bullestock/chairbot/arm/grblHAL/settings.txt

GrblHAL 1.1f ['$' or '$HELP' for help]
$0=10.0
$1=25
$2=0
$3=0
$4=7
$5=7
$6=1
$9=1
$10=511
$11=0.010
$12=0.002
$13=0
$14=7
$15=0
$16=0
$17=0
$18=1
$19=0
$20=1
$21=0
$22=11
$23=1
$24=250.0
$25=1000.0
$26=250
$27=5.000
$28=0.100
$29=0.0
$30=1000.000
$31=0.000
$32=0
$33=5000.0
$34=0.0
$35=0.0
$36=100.0
$37=0
$39=1
$40=0
$43=1
$44=4
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
ok
