bullestock/chairbot/base.dxf

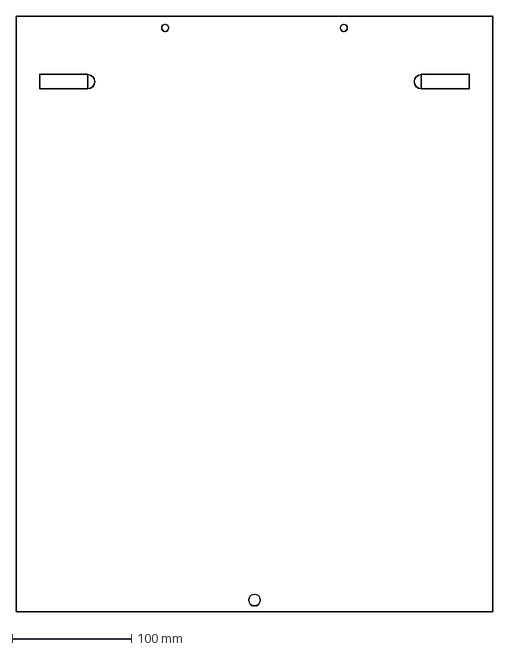
[picture p1: CAD file, 2016-07-29]
base.dxf
400.0 x 500.0 mm
