bullestock/chairbot/spacer.dxf

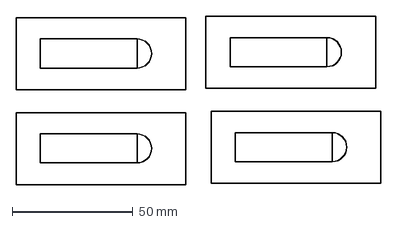
[picture p2: CAD file, 2016-07-29]
spacer.dxf
150.8 x 69.6 mm
