bullestock/chairbot/pcb/peripherals/peripherals.kicad_pcb

## KiCad design pcb/peripherals/peripherals.kicad_pcb (2026-04-26)

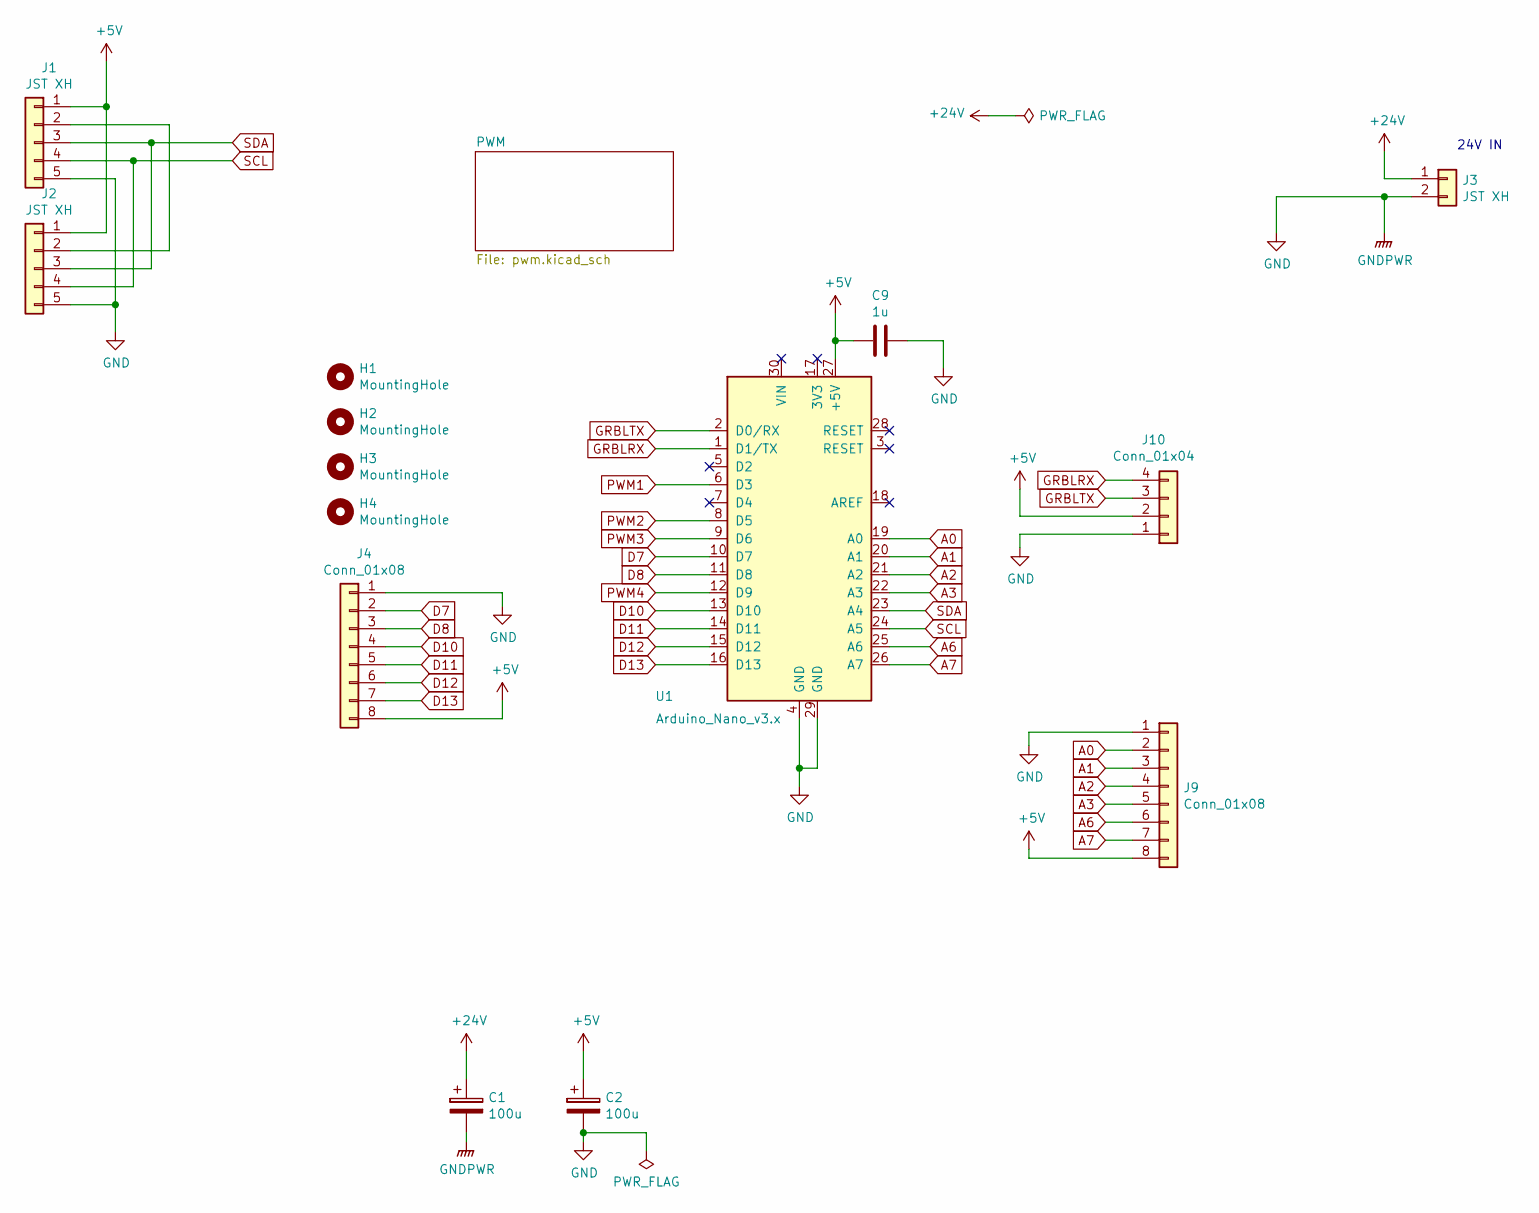
[picture p3: schematic peripherals.kicad_sch]

Parts:
C1, C2: 100u; CP_Elec_10x10
C9: 1u; C_0805_2012Metric
H1, H2, H3, H4: MountingHole; MountingHole_3.2mm_M3
J1, J2: JST XH; JST_XH_B05B-XH-A_1x05_P2.50mm_Vertical
J3: JST XH; JST_XH_B02B-XH-A_1x02_P2.50mm_Vertical
J4, J9: Conn_01x08; JST_XH_B08B-XH-A_1x08_P2.50mm_Vertical
J10: Conn_01x04; JST_XH_B04B-XH-A_1x04_P2.50mm_Vertical
U1: Arduino_Nano_v3.x; Arduino_Nano

Connections:
+5V: C2.1, C9.2, J1.1, J2.1, J4.8, J9.8, J10.2, U1.27 (+5V)
+24V: C1.1, J3.1; also elsewhere on the board
A0: J9.2, U1.19 (A0)
A1: J9.3, U1.20 (A1)
A2: J9.4, U1.21 (A2)
A3: J9.5, U1.22 (A3)
A6: J9.6, U1.25 (A6)
A7: J9.7, U1.26 (A7)
D7: J4.2, U1.10 (D7)
D8: J4.3, U1.11 (D8)
D10: J4.4, U1.13 (D10)
D11: J4.5, U1.14 (D11)
D12: J4.6, U1.15 (D12)
D13: J4.7, U1.16 (D13)
GND: C1.2, C2.2, C9.1, J1.5, J2.5, J3.2, J4.1, J9.1, J10.1, U1.4 (GND), U1.29 (GND); also elsewhere on the board
GRBLRX: J10.4, U1.1 (D1/TX)
GRBLTX: J10.3, U1.2 (D0/RX)
unnamed: J1.2, J2.2
PWM1: U1.6 (D3); also elsewhere on the board
PWM2: U1.8 (D5); also elsewhere on the board
PWM3: U1.9 (D6); also elsewhere on the board
PWM4: U1.12 (D9); also elsewhere on the board
SCL: J1.4, J2.4, U1.24 (A5)
SDA: J1.3, J2.3, U1.23 (A4)

Notes on the sheet:
24V IN

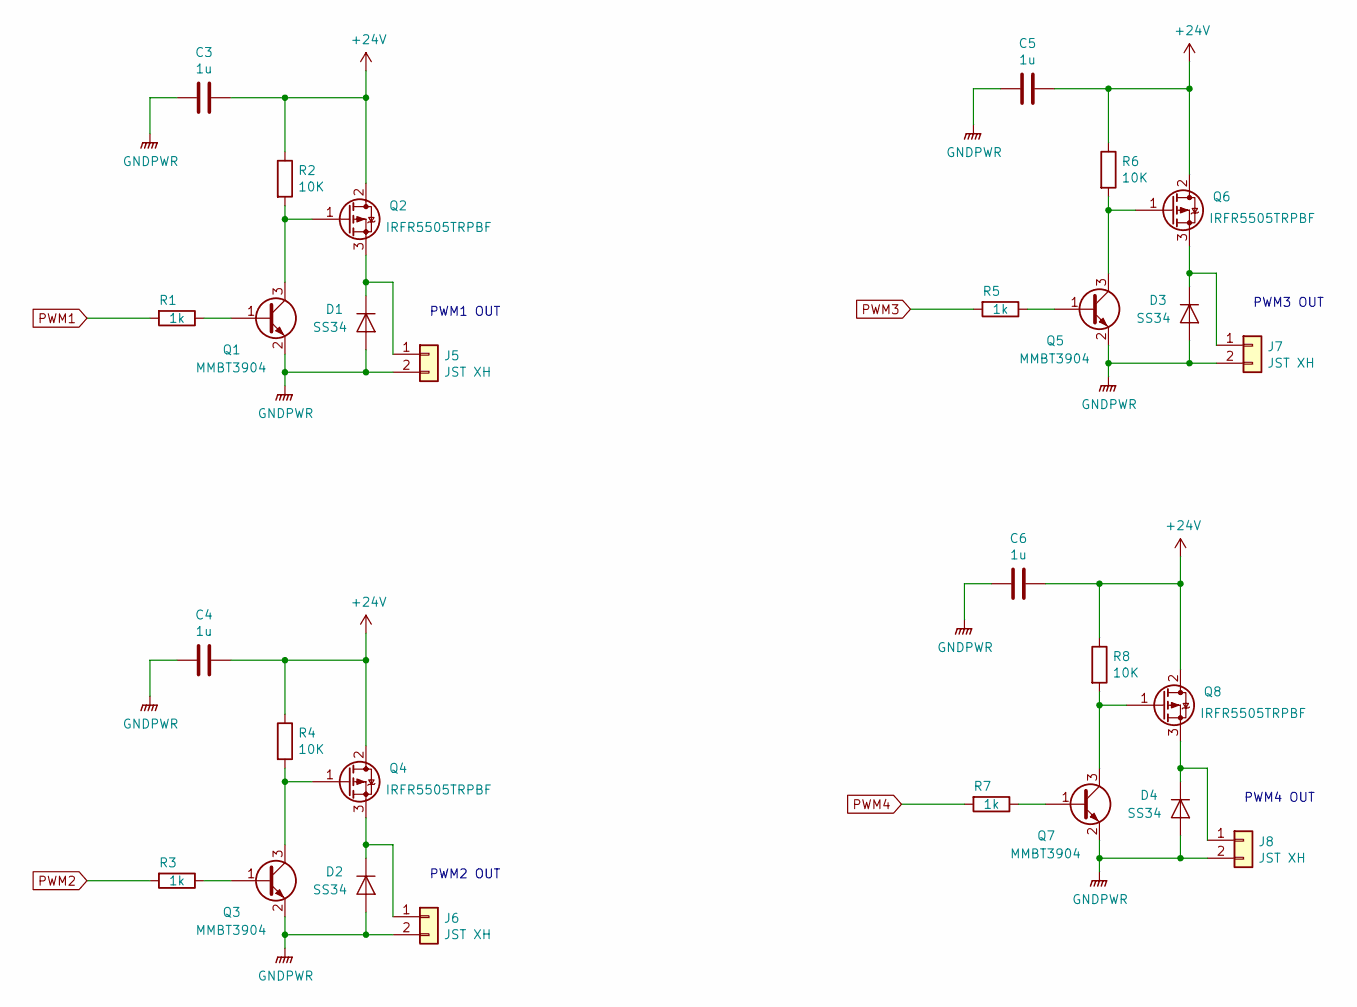
[picture p4: schematic pwm.kicad_sch]

Parts:
C3, C4, C5, C6: 1u; C_0805_2012Metric
D1, D2, D3, D4: SS34; D_SMB
J5, J6, J7, J8: JST XH; JST_XH_B02B-XH-A_1x02_P2.50mm_Vertical
Q1, Q3, Q5, Q7: MMBT3904; SOT-23
Q2, Q4, Q6, Q8: IRFR5505TRPBF; TO-252-3_TabPin2
R1, R3, R5, R7: 1k; R_0603_1608Metric
R2, R4, R6, R8: 10K; R_0603_1608Metric

Connections:
+24V: C3.1, C4.1, C5.1, C6.1, Q2.2 (D), Q4.2 (D), Q6.2 (D), Q8.2 (D), R2.1, R4.1, R6.1, R8.1; also elsewhere on the board
GND: C3.2, C4.2, C5.2, C6.2, D1.2 (A), D2.2 (A), D3.2 (A), D4.2 (A), J5.2, J6.2, J7.2, J8.2, Q1.2 (E), Q3.2 (E), Q5.2 (E), Q7.2 (E); also elsewhere on the board
unnamed: D1.1 (K), J5.1, Q2.3 (S)
unnamed: D2.1 (K), J6.1, Q4.3 (S)
unnamed: D3.1 (K), J7.1, Q6.3 (S)
unnamed: D4.1 (K), J8.1, Q8.3 (S)
unnamed: Q1.1 (B), R1.1
unnamed: Q1.3 (C), Q2.1 (G), R2.2
unnamed: Q3.1 (B), R3.1
unnamed: Q3.3 (C), Q4.1 (G), R4.2
unnamed: Q5.1 (B), R5.1
unnamed: Q5.3 (C), Q6.1 (G), R6.2
unnamed: Q7.1 (B), R7.1
unnamed: Q7.3 (C), Q8.1 (G), R8.2
PWM1: R1.2; also elsewhere on the board
PWM2: R3.2; also elsewhere on the board
PWM3: R5.2; also elsewhere on the board
PWM4: R7.2; also elsewhere on the board

Notes on the sheet:
PWM3 OUT
PWM1 OUT
PWM4 OUT
PWM2 OUT

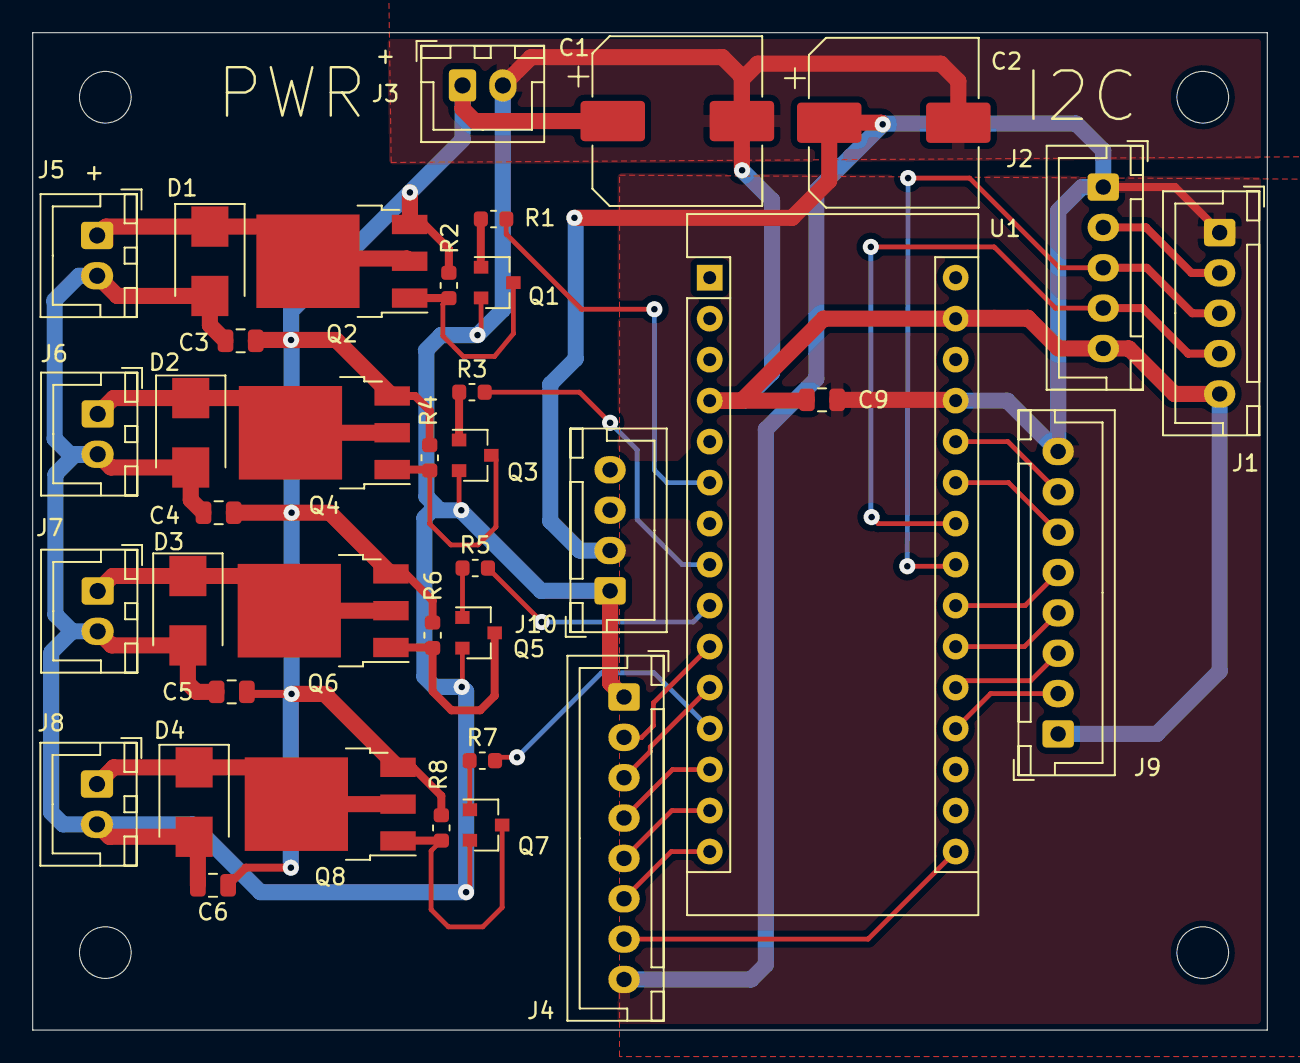
[picture p5: board peripherals.kicad_pcb from above]

Board: 2 copper layers, 76.5 x 61.8 mm, 42 parts (0 on the bottom side), 36 nets.
