bullestock/chairbot/pcb/chairbot/chairbot.kicad_pcb

## KiCad design pcb/chairbot/chairbot.kicad_pcb (2026-04-03)

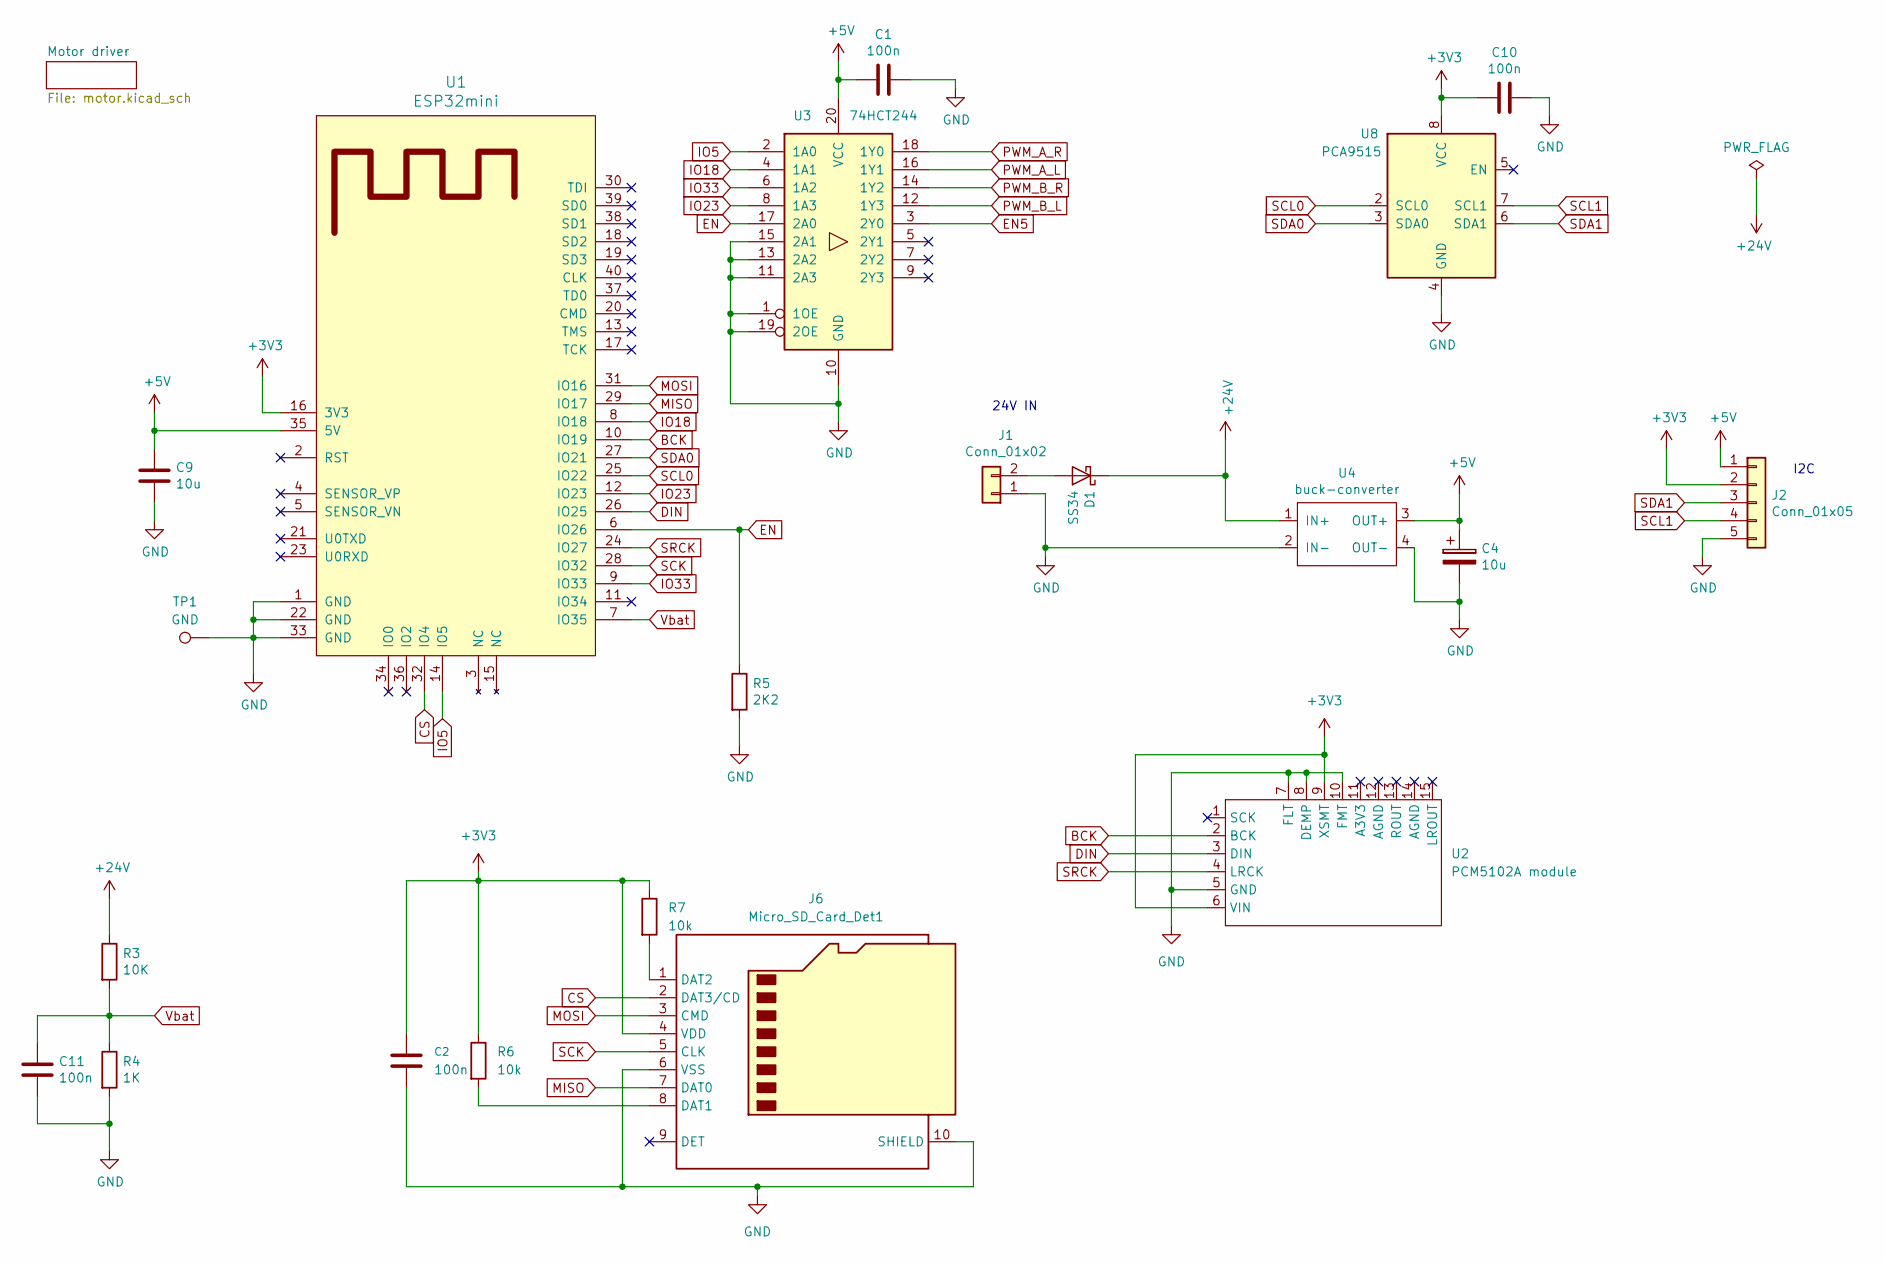
[picture p6: schematic chairbot.kicad_sch]

Parts:
C1, C2, C10, C11: 100n; C_0603_1608Metric
C4, C9: 10u; C_0805_2012Metric
D1: SS34; D_SMB
J1: Conn_01x02; JST_XH_B02B-XH-A_1x02_P2.50mm_Vertical
J2: Conn_01x05; JST_XH_B05B-XH-A_1x05_P2.50mm_Vertical
J6: Micro_SD_Card_Det1; J_SD_Card-micro_dual
R3: 10K; R_0603_1608Metric
R4: 1K; R_0603_1608Metric
R5: 2K2; R_0603_1608Metric
R6, R7: 10k; R_0603_1608Metric
TP1: GND; TestPoint_Loop_D1.80mm_Drill1.0mm_Beaded
U1: ESP32mini
U2: PCM5102A module
U3: 74HCT244; TSSOP-20_4.4x6.5mm_P0.65mm
U4: buck-converter
U8: PCA9515; TSSOP-8_3x3mm_P0.65mm

Connections:
+3V3: C2.1, C10.2, J2.2, J6.4 (VDD), R6.1, R7.1, U1.16 (3V3), U2.6 (VIN), U2.9 (XSMT), U8.8 (VCC)
+5V: C1.2, C4.1, C9.1, J2.1, U1.35 (5V), U3.20 (VCC), U4.3 (OUT+); also elsewhere on the board
+24V: D1.1 (K), R3.1, U4.1 (IN+); also elsewhere on the board
BCK: U1.10 (IO19), U2.2 (BCK)
CS: J6.2 (DAT3/CD), U1.32 (IO4)
DIN: U1.26 (IO25), U2.3 (DIN)
EN: R5.1, U1.6 (IO26), U3.17 (2A0)
EN5: U3.3 (2Y0); also elsewhere on the board
GND: C1.1, C2.2, C4.2, C9.2, C10.1, C11.2, J1.1, J2.5, J6.6 (VSS), J6.10 (SHIELD), R4.2, R5.2, TP1.1 (1_1), U1.1 (GND), U1.22 (GND), U1.33 (GND), U2.5 (GND), U2.7 (FLT), U2.8 (DEMP), U2.10 (FMT), U3.1 (1OE), U3.10 (GND), U3.11 (2A3), U3.13 (2A2), U3.15 (2A1), U3.19 (2OE), U4.2 (IN-), U4.4 (OUT-), U8.4 (GND); also elsewhere on the board
IO5: U1.14 (IO5), U3.2 (1A0)
IO18: U1.8 (IO18), U3.4 (1A1)
IO23: U1.12 (IO23), U3.8 (1A3)
IO33: U1.9 (IO33), U3.6 (1A2)
MISO: J6.7 (DAT0), U1.29 (IO17)
MOSI: J6.3 (CMD), U1.31 (IO16)
unnamed: D1.2 (A), J1.2
unnamed: J6.8 (DAT1), R6.2
unnamed: J6.1 (DAT2), R7.2
PWM_A_L: U3.16 (1Y1); also elsewhere on the board
PWM_A_R: U3.18 (1Y0); also elsewhere on the board
PWM_B_L: U3.12 (1Y3); also elsewhere on the board
PWM_B_R: U3.14 (1Y2); also elsewhere on the board
SCK: J6.5 (CLK), U1.28 (IO32)
SCL0: U1.25 (IO22), U8.2 (SCL0)
SCL1: J2.4, U8.7 (SCL1)
SDA0: U1.27 (IO21), U8.3 (SDA0)
SDA1: J2.3, U8.6 (SDA1)
SRCK: U1.24 (IO27), U2.4 (LRCK)
Vbat: C11.1, R3.2, R4.1, U1.7 (IO35)

Notes on the sheet:
I2C
24V IN

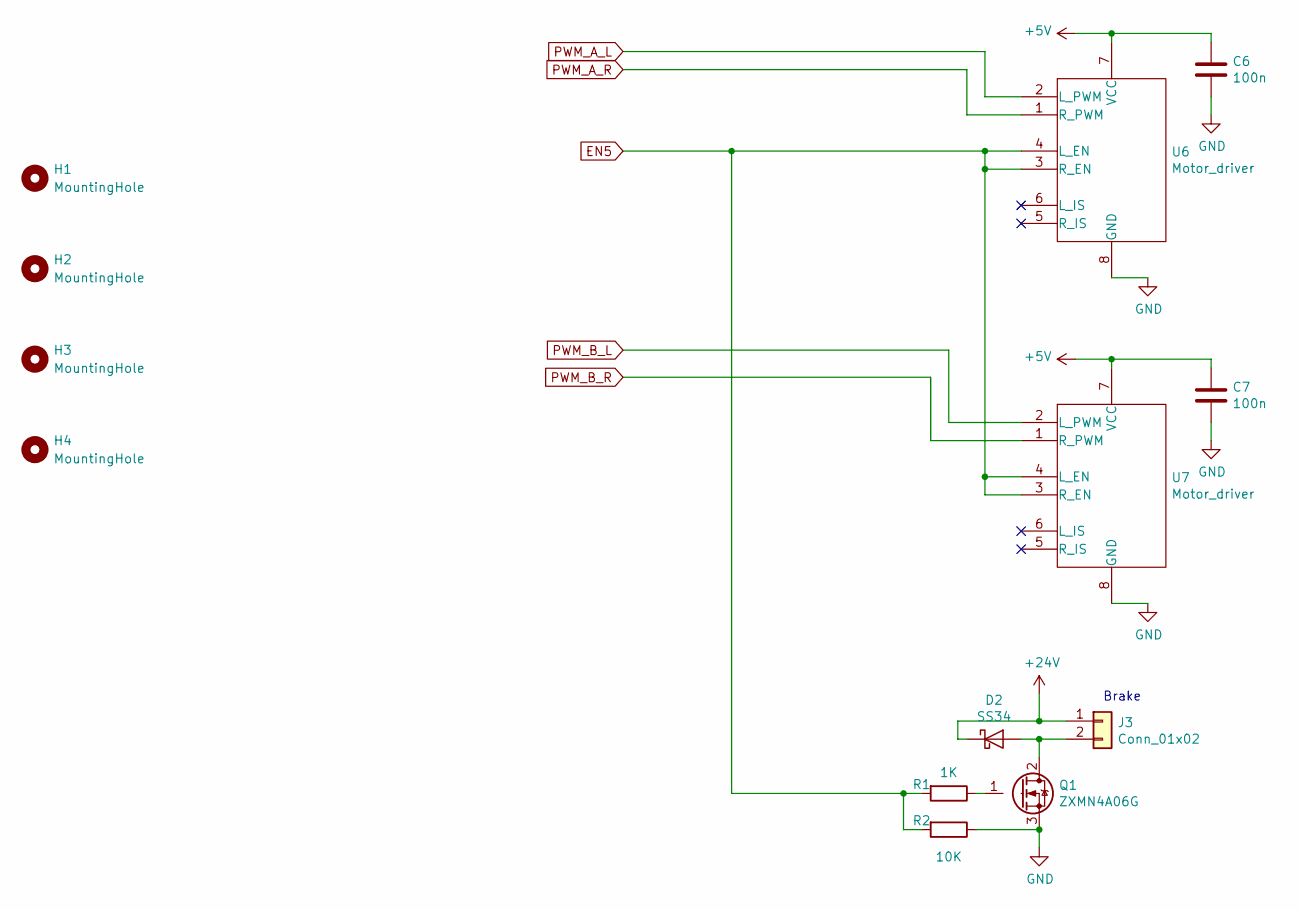
[picture p7: schematic motor.kicad_sch]

Parts:
C6, C7: 100n; C_0603_1608Metric
D2: SS34; D_SMB
H1, H2, H3, H4: MountingHole; MountingHole_3.2mm_M3
J3: Conn_01x02; JST_XH_B02B-XH-A_1x02_P2.50mm_Vertical
Q1: ZXMN4A06G; SOT-223-3_TabPin2
R1: 1K; R_0603_1608Metric
R2: 10K; R_0603_1608Metric
U6, U7: Motor_driver; PinSocket_2x04_P2.54mm_Horizontal

Connections:
+5V: C6.1, C7.1, U6.7 (VCC), U7.7 (VCC); also elsewhere on the board
+24V: D2.1 (K), J3.1; also elsewhere on the board
EN5: R1.2, R2.2, U6.3 (R_EN), U6.4 (L_EN), U7.3 (R_EN), U7.4 (L_EN); also elsewhere on the board
GND: C6.2, C7.2, Q1.3 (S), R2.1, U6.8 (GND), U7.8 (GND); also elsewhere on the board
unnamed: D2.2 (A), J3.2, Q1.2 (D)
unnamed: Q1.1 (G), R1.1
PWM_A_L: U6.2 (L_PWM); also elsewhere on the board
PWM_A_R: U6.1 (R_PWM); also elsewhere on the board
PWM_B_L: U7.2 (L_PWM); also elsewhere on the board
PWM_B_R: U7.1 (R_PWM); also elsewhere on the board

Notes on the sheet:
Brake

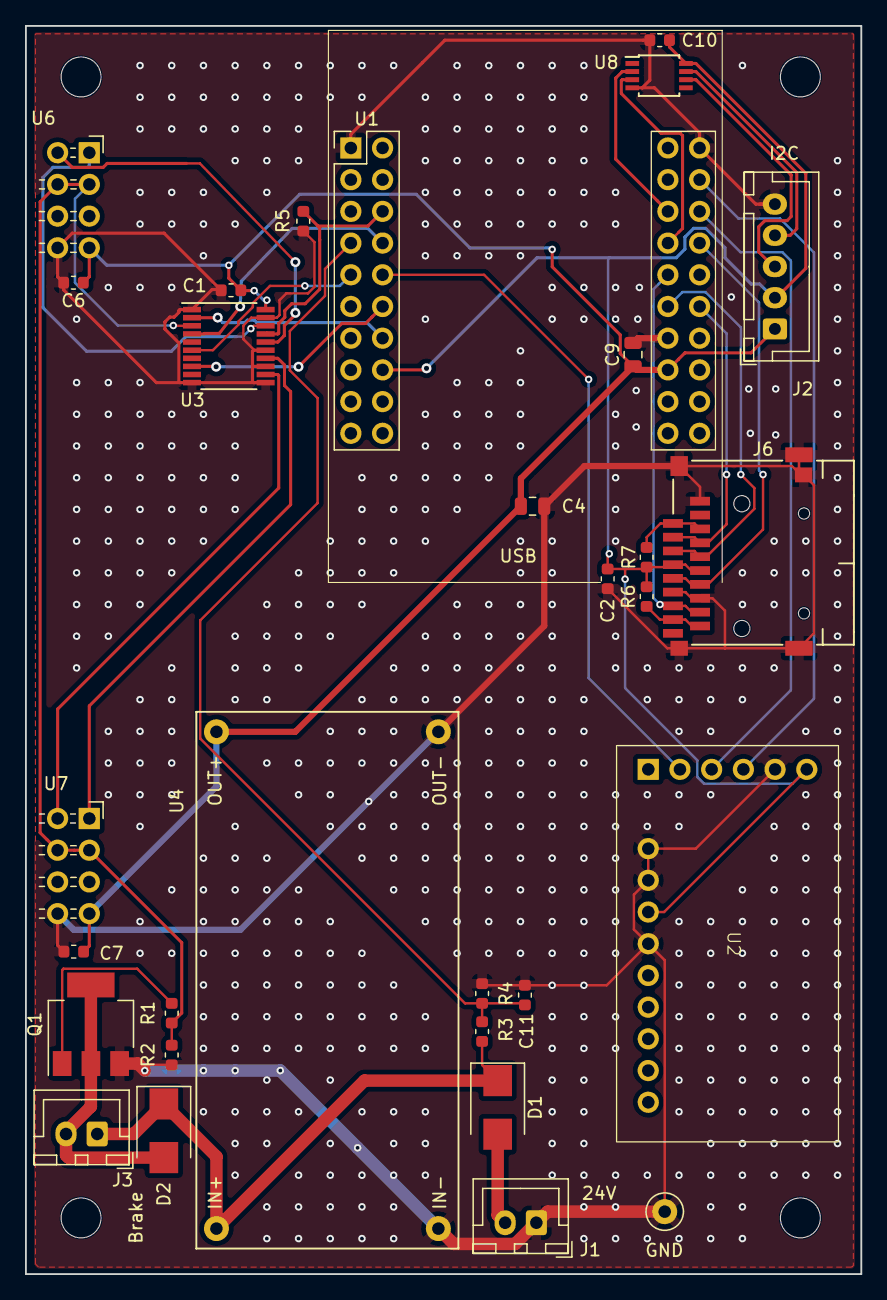
[picture p8: board chairbot.kicad_pcb from above]

Board: 2 copper layers, 66.9 x 100.0 mm, 34 parts (0 on the bottom side), 31 nets.
