bullestock/chairbot/pcb/powerbar/powerbar.kicad_pcb

## KiCad design pcb/powerbar/powerbar.kicad_pcb (2020-09-17)

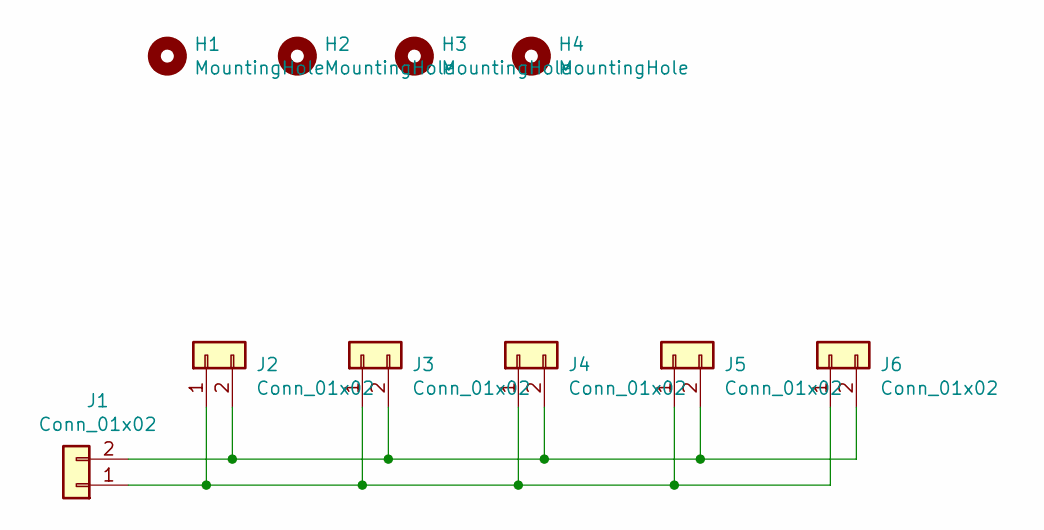
[picture p9: schematic powerbar.sch]

Parts:
H1, H2, H3, H4: MountingHole; MountingHole_3.2mm_M3
J1: Conn_01x02; PhoenixContact_MCV_1,5_2-G-5.08_1x02_P5.08mm_Vertical
J2, J3, J4, J5, J6: Conn_01x02; JST_XH_B02B-XH-A_1x02_P2.50mm_Vertical

Connections:
unnamed: J1.1, J2.1, J3.1, J4.1, J5.1, J6.1
unnamed: J1.2, J2.2, J3.2, J4.2, J5.2, J6.2

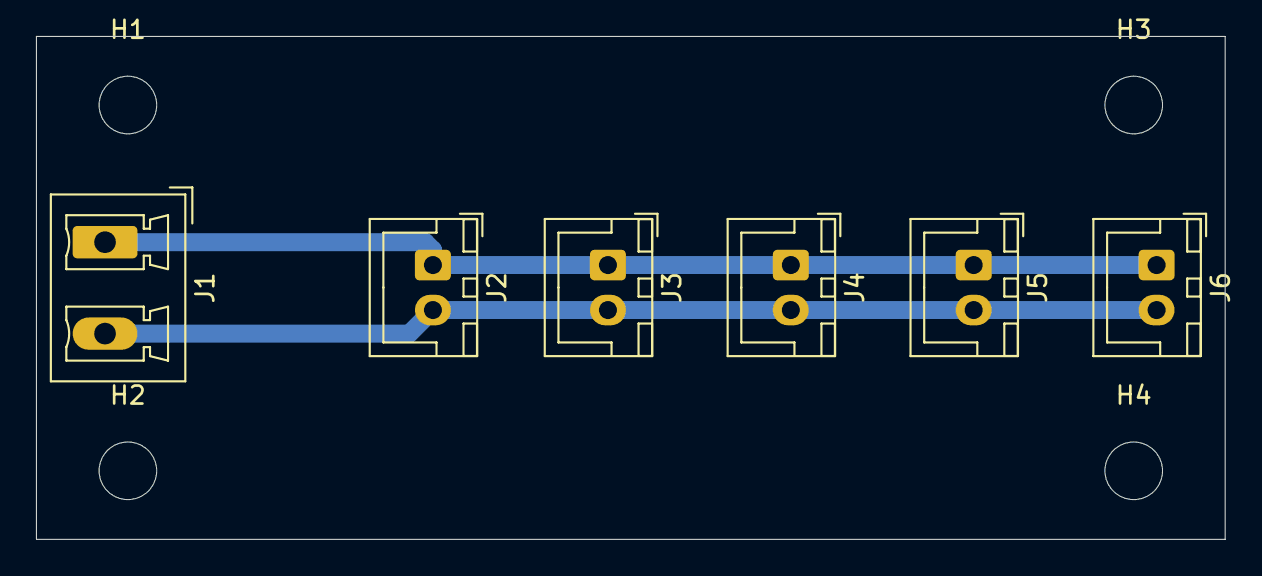
[picture p10: board powerbar.kicad_pcb from above]

Board: 2 copper layers, 66.0 x 27.9 mm, 10 parts (0 on the bottom side), 2 nets.
