bullestock/chairbot/peakdetector/peakdetector.kicad_pcb

## KiCad design peakdetector/peakdetector.kicad_pcb (2018-08-17)

Schematic: peakdetector.sch

Parts:
C1, C2, C3: 220n; C_0603
D1, D2, D3, D4: BAT54; D_SOT-23_ANK
J1: Conn_01x07_Male; Pin_Header_Straight_1x07_Pitch2.54mm
R1, R2: 100K; R_0603
U1: TL074; SOP14

Connections:
+5V: C3.1, J1.7, U1.4 (V+)
GND: C1.2, C2.2, C3.2, D1.2, D2.2, J1.1, R1.2, R2.2, U1.11 (V-)
unnamed: C1.1, D3.1, R1.1, U1.2 (-), U1.5 (+)
unnamed: C2.1, D4.1, R2.1, U1.9 (-), U1.12 (+)
unnamed: D1.1, D3.2, U1.1
unnamed: D2.1, D4.2, U1.8
unnamed: J1.2, U1.3 (+)
unnamed: J1.3, U1.6 (-), U1.7
unnamed: J1.4, U1.10 (+)
unnamed: J1.5, U1.13 (-), U1.14

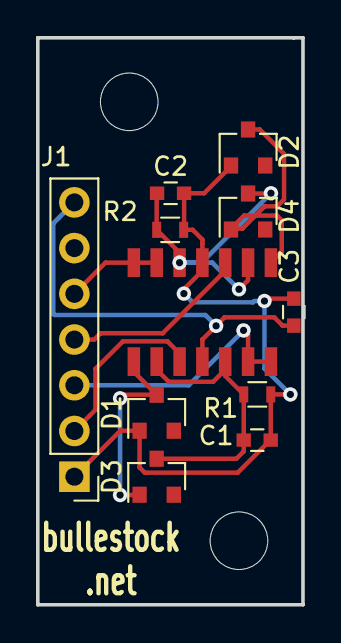
[picture p11: board peakdetector.kicad_pcb from above]

Board: 2 copper layers, 14.7 x 31.5 mm, 11 parts (0 on the bottom side), 10 nets.
