bullestock/chairbot/nerfgun/grblhal-settings.txt

$0=5.0
$1=25
$2=0
$3=1
$4=15
$5=15
$6=1
$9=1
$10=511
$11=0.010
$12=0.002
$13=0
$14=64
$15=0
$16=0
$17=0
$18=0
$19=0
$20=1
$21=0
$22=11
$23=1
$24=200.0
$25=1000.0
$26=250
$27=10.000
$28=0.100
$29=0.0
$30=1000.000
$31=0.000
$32=0
$33=5000.0
$34=0.0
$35=0.0
$36=100.0
$37=0
$39=1
$40=0
$41=0
$42=2
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
