bullestock/chairbot/ctrlr/motor.cpp

#include "motor.h"

#include <linux/i2c-dev.h>

#include <cmath>
#include <cstdlib>
#include <iostream>
#include <errno.h>
#include <string.h>
#include <unistd.h>

#include <sys/types.h>
#include <sys/stat.h>
#include <fcntl.h>

using namespace std;

const int MOTOR_STATUS = 0x00;
const int MOTOR_PWR = 0x01;
const int MOTOR_VOLTAGE = 0x02;
const int MOTOR_PWM = 0x03;

bool motor_init(int& i2c_device)
{
    i2c_device = open("/dev/i2c-1", O_RDWR);
    if (i2c_device < 0)
    {
        cout << "No I2C device found" << endl;
        return false;
    }

    const int motor_addr = 0x04;

    if (ioctl(i2c_device, I2C_SLAVE, motor_addr) < 0)
    {
        cout << "Error setting up I2C: " << strerror(errno) << endl;
        return false;
    }        
    return true;
}

bool motor_set(int i2c_device, int power_left, int power_right)
{
    static int count = 0;
    const uint8_t data[4] = {
        MOTOR_PWR,
        static_cast<uint8_t>((power_left < 0 ? 0x01 : 0) | (power_right < 0 ? 0x02 : 0)),
        static_cast<uint8_t>(abs(power_left)),
        static_cast<uint8_t>(abs(power_right))
    };
    ++count;
    if (write(i2c_device, data, sizeof(data)) != sizeof(data))
    {
        cout << "Error writing I2C (motor power): " << strerror(errno) << " (" << count << ")" << endl;
        return false;
    }
    return true;
}

bool motor_set_pwm_freq(int i2c_device, int pin, int mode)
{
    static int count = 0;
    const uint8_t data[3] = {
        MOTOR_PWM,
        static_cast<uint8_t>(pin),
        static_cast<uint8_t>(mode)
    };
    ++count;
    if (write(i2c_device, data, sizeof(data)) != sizeof(data))
    {
        cout << "Error writing I2C (motor pwm): " << strerror(errno) << " (" << count << ")" << endl;
        return false;
    }
    return true;
}

int32_t motor_get_battery(int i2c_device)
{
    const uint8_t data[1] = {
        MOTOR_VOLTAGE
    };
    if (write(i2c_device, data, sizeof(data)) != sizeof(data))
    {
        cout << "Error writing I2C (battery): " << strerror(errno) << endl;
        return -1;
    }
    uint8_t v;
    if (read(i2c_device, &v, 1) != 1)
    {
        cout << "Error reading I2C: " << strerror(errno) << endl;
        return -1;
    }
    return static_cast<int32_t>(v*4/1023.0*5*11*1000);
}

static const int max_range = 512;

int apply_s_curve(int x)
{
    if (x >= max_range)
        x = max_range-1;
    else if (x <= -max_range)
        x = -(max_range-1);

    const auto max_logit = 6.93;

    const auto scaled = 0.5 + abs(x)/static_cast<double>(2*max_range);
    // Logit function
    return -log(1.0/scaled - 1)*(x > 0 ? max_range/max_logit : -max_range/max_logit);
}

void compute_power(int rx, int ry, int& power_left, int& power_right, int pivot, int max_power)
{
    rx = apply_s_curve(rx);
    ry = apply_s_curve(ry);
                
    int nMotPremixL = 0;
    int nMotPremixR = 0;
    // Calculate Drive Turn output due to Joystick X input
    if (ry >= 0)
    {
        // Forward
        nMotPremixL = rx >= 0 ? max_range : max_range + rx;
        nMotPremixR = rx >= 0 ? max_range - rx : max_range;
    }
    else
    {
        // Reverse
        nMotPremixL = rx >= 0 ? max_range - rx : max_range;
        nMotPremixR = rx >= 0 ? max_range : max_range + rx;
    }

    // Scale Drive output due to Joystick Y input (throttle)
    nMotPremixL = nMotPremixL * ry/(max_range+1.0);
    nMotPremixR = nMotPremixR * ry/(max_range+1.0);

    // Now calculate pivot amount
    // - Strength of pivot (nPivSpeed) based on Joystick X input
    // - Blending of pivot vs drive (fPivScale) based on Joystick Y input
    const auto nPivSpeed = rx;
    const auto fPivScale = abs(ry) > pivot ? 0.0 : 1.0 - abs(ry)/float(pivot);

    // Calculate final mix of Drive and Pivot and convert to motor PWM range
    power_left = int(-((1.0-fPivScale)*nMotPremixL + fPivScale*(nPivSpeed))/float(max_range)*max_power);
    power_right = int(-((1.0-fPivScale)*nMotPremixR + fPivScale*(-nPivSpeed))/float(max_range)*max_power);
}
