bullestock/chairbot/esp32/main/motor.h

#pragma once

#include <driver/gpio.h>
#include <driver/ledc.h>

#include <memory>

class Motor
{
public:
    Motor(ledc_timer_t _timer,
          ledc_channel_t _channel_a,
          ledc_channel_t _channel_b,
          gpio_num_t _pwm_a,
          gpio_num_t _pwm_b,
          unsigned _frequency = 1000);

    // -1.0 to 1.0
    void set_speed(float speed);

private:
    ledc_timer_t timer = (ledc_timer_t) 0;
    ledc_channel_t channel_a = (ledc_channel_t) 0;
    ledc_channel_t channel_b = (ledc_channel_t) 0;
    float last_speed = 0.0;
    int64_t last_tick = 0;
};

void compute_power(float rx, float ry, float& power_left, float& power_right, float pivot);

// -1.0 to 1.0
void set_motors(float m1, float m2);

extern std::unique_ptr<Motor> motor_a;
extern std::unique_ptr<Motor> motor_b;

// Local Variables:
// compile-command: "(cd ..; idf.py build)"
// End:
