bullestock/chairbot/esp32/main/console.cpp

#include "console.h"

#include "battery.h"
#include "config.h"
#include "i2s_audio.h"
#include "motor.h"
#include "nvs.h"
#include "peripherals.h"
#include "radio.h"

#include <string.h>

#include <chrono>
#include <limits>
#include <random>

#include <esp_system.h>
#include <esp_log.h>
#include <esp_console.h>

#include <driver/i2c_master.h>
#include <driver/uart.h>
#include <driver/uart_vfs.h>

#include <linenoise/linenoise.h>
#include <argtable3/argtable3.h>

int motor_test(int argc, char** argv)
{
    int count = 1;
    bool only_a = false;
    bool only_b = false;
    if (argc > 1)
    {
        if (isdigit(argv[1][0]))
            count = atoi(argv[1]);
        else if (!strcmp(argv[1], "a"))
            only_a = true;
        else if (!strcmp(argv[1], "b"))
            only_b = true;
        else if (!strcmp(argv[1], "A"))
        {
            only_a = true;
            count = std::numeric_limits<int>::max();
        }
        else if (!strcmp(argv[1], "B"))
        {
            only_b = true;
            count = std::numeric_limits<int>::max();
        }
        else if (!strcmp(argv[1], "brake"))
        {
            printf("Running brake test\n");
            set_motors(0, 0);
            for (int j = 0; j < 5; ++j)
            {
                gpio_set_level(GPIO_ENABLE, 1);
                vTaskDelay(5000/portTICK_PERIOD_MS);
                gpio_set_level(GPIO_ENABLE, 0);
                vTaskDelay(5000/portTICK_PERIOD_MS);
            }
            printf("done\n");
            return 0;
        }
    }

    printf("Running motor test (%d)\n", count);
    for (int j = 0; j < count; ++j)
    {
        set_motors(0, 0);
        if (!only_b)
        {
            for (int i = 10; i <= 100; ++i)
            {
                if (!(i % 10))
                    printf("A %d\n", i);
                set_motors(i/100.0, 0);
                vTaskDelay(50/portTICK_PERIOD_MS);
            }
            for (int i = 100; i >= -100; --i)
            {
                if (!(i % 10))
                    printf("A %d\n", i);
                set_motors(i/100.0, 0);
                vTaskDelay(50/portTICK_PERIOD_MS);
            }
            for (int i = -100; i <= 0; ++i)
            {
                if (!(i % 10))
                    printf("A %d\n", i);
                set_motors(i/100.0, 0);
                vTaskDelay(50/portTICK_PERIOD_MS);
            }
            set_motors(0, 0);
            vTaskDelay(1000/portTICK_PERIOD_MS);
        }
        if (!only_a)
        {
            for (int i = 10; i <= 100; ++i)
            {
                if (!(i % 10))
                    printf("B %d\n", i);
                set_motors(0, i/100.0);
                vTaskDelay(50/portTICK_PERIOD_MS);
            }
            for (int i = 100; i >= -100; --i)
            {
                if (!(i % 10))
                    printf("B %d\n", i);
                set_motors(0, i/100.0);
                vTaskDelay(50/portTICK_PERIOD_MS);
            }
            for (int i = -100; i <= 0; ++i)
            {
                if (!(i % 10))
                    printf("B %d\n", i);
                set_motors(0, i/100.0);
                vTaskDelay(50/portTICK_PERIOD_MS);
            }
            set_motors(0, 0);
            vTaskDelay(1000/portTICK_PERIOD_MS);
        }
    }
    return 0;
}

int i2c_cmd(int argc, char** argv)
{
    static const char* i2c_usage =
       "Valid commands:\n"
       "scan [<count>]       Scan for I2C devices\n"
       "read <addr>          Read from device at specified address\n"
       "write <addr> <data>  Write to device at specified address\n";

    if (argc < 2)
    {
        printf("Error: Missing command\n");
        printf(i2c_usage);
        return -1;
    }
    if (!strcmp(argv[1], "scan"))
    {
        int count = 1;
        if (argc > 2)
            count = atoi(argv[2]);
        printf("Scanning for I2C devices (%d)\n", count);
        for (int j = 0; j < count; ++j)
        {
            printf("     0  1  2  3  4  5  6  7  8  9  a  b  c  d  e  f\n");
            for (int i = 0; i < 128; i += 16)
            {
                printf("%02X: ", i);
                for (int j = 0; j < 16; j++)
                {
                    fflush(stdout);
                    uint8_t address = i + j;
                    esp_err_t ret = i2c_master_probe(i2c_bus_handle, address, 50);
                    if (ret == ESP_OK)
                        printf("%02X ", address);
                    else if (ret == ESP_ERR_TIMEOUT)
                        printf("UU ");
                    else
                        printf("-- ");
                }
                printf("\n");
            }
            vTaskDelay(100/portTICK_PERIOD_MS);
        }
        return 0;
    }
    if (!strcmp(argv[1], "read"))
    {
        printf("Error: Read not implemented\n");
        return 0;
    }
    if (!strcmp(argv[1], "write"))
    {
        if (argc < 3)
        {
            printf("Error: Missing address\n");
            printf(i2c_usage);
            return -1;
        }
        const uint16_t address = atoi(argv[2]);

        if (argc < 4)
        {
            printf("Error: Missing data\n");
            printf(i2c_usage);
            return -1;
        }
        const uint8_t data = atoi(argv[3]);

        i2c_device_config_t i2c_dev_conf = {
            .device_address = address,
            .scl_speed_hz = 100000,
        };
        i2c_master_dev_handle_t dev_handle;
        auto ret = i2c_master_bus_add_device(i2c_bus_handle, &i2c_dev_conf, &dev_handle);
        if (ret != ESP_OK)
        {
            printf("i2c_master_bus_add_device() failed: %d\n", ret);
            return 1;
        }

        uint8_t bytes[1];
        bytes[0] = data;
        
        ret = i2c_master_transmit(dev_handle, bytes, 1, 50);
        if (ret == ESP_OK) 
            printf("Write OK\n");
        else if (ret == ESP_ERR_TIMEOUT)
            printf("Bus is busy\n");
        else 
            printf("i2c_master_transmit() failed: %d\n", ret);

        if (i2c_master_bus_rm_device(dev_handle) != ESP_OK)
        {
            printf("i2c_master_bus_rm_device() failed\n");
            return 1;
        }
        return 0;
    }
    printf("Error: Unknown command\n");
    printf(i2c_usage);
    return -1;
}

int read_battery(int argc, char** argv)
{
    Battery bat;
    for (int i = 0; i < 10; ++i)
    {
        printf("Battery voltage: %f V\n", bat.read_voltage());
        vTaskDelay(100/portTICK_PERIOD_MS);
    }

    return 0;
}

int sound(int argc, char** argv)
{
    static const char* sound_usage =
        "Valid commands:\n"
        "sound                   Show tracks\n"
        "sound <effect> <index>  Play specified track\n"
        "sound check             Check sounds\n"
        "sound random            Play a random effect\n"
        "sound stop              Stop playing\n"
        "sound volume            Set volume (0-100)\n";

    if (argc < 2)
    {
        for (int j = 0; j < 2; ++j)
        {
            printf("%s:\n", j == 0 ? "Effects" : "Music");
            const auto tracks = sd_get_tracks(j == 0);
            int i = 0;
            for (const auto& e : tracks)
            {
                printf("%3d: %s\n", i, e.c_str());
                ++i;
            }
        }
        return 0;
    }
    if (!strcmp(argv[1], "-h") || !strcmp(argv[1], "--help") || !strcmp(argv[1], "help"))
    {
        printf(sound_usage);
        return 0;
    }
    if (!strcmp(argv[1], "check"))
    {
        for (int j = 0; j < 2; ++j)
        {
            printf("%s:\n", j == 0 ? "Effects" : "Music");
            const auto tracks = sd_get_tracks(j == 0);
            for (int i = 0; i < tracks.size(); ++i)
            {
                std::string status = "OK";
                if (check_sd_track(j == 0, i, status))
                    printf("%3d: OK\n", i);
                else
                    printf("%3d: (%s) %s\n", i, tracks[i].c_str(), status.c_str());
            }
        }
        return 0;
    }
    if (!strcmp(argv[1], "random"))
    {
        unsigned seed = std::chrono::system_clock::now().time_since_epoch().count();
        std::default_random_engine generator(seed);
        std::uniform_int_distribution<int> distribution(0, get_sd_track_count(true));
        const int index = distribution(generator);
        printf("Playing effect %d\n", index);
        start_sd_playback(true, index);
        return 0;
    }
    if (!strcmp(argv[1], "stop"))
    {
        stop_sd_playback();
        return 0;
    }
    if (!strcmp(argv[1], "volume"))
    {
        if (argc < 3 || !isdigit(argv[2][0]))
        {
            printf(sound_usage);
            return 0;
        }
        const int volume = atoi(argv[2]);
        if (volume < 0 || volume > 100)
        {
            printf("Error: Invalid volume\n");
            return -1;
        }
        set_sd_volume(volume);
        return 0;
    }
    if (argc < 3 || !isdigit(argv[2][0]))
    {
        printf(sound_usage);
        return 0;
    }
    const auto is_effects = argv[1][0] == 'e';
    const int index = atoi(argv[1]);
    if (index < 0 || index >= get_sd_track_count(is_effects))
    {
        printf("Error: Invalid track index\n");
        return -1;
    }
    start_sd_playback(is_effects, index);
    return 0;
}

int control_peripherals(int argc, char** argv)
{
    static const char* peripherals_usage =
       "Valid commands:\n"
       "pwm <addr> <duty> <freq>  Set PWM output\n"
       "uartwr <data>             Write data via UART passthrough\n"
       "uartrd                    Read data via UART passthrough\n";

    if (argc < 2)
    {
        printf("Error: Missing command\n");
        printf(peripherals_usage);
        return -1;
    }
    if (!strcmp(argv[1], "pwm"))
    {
        if (argc < 3)
        {
            printf("Error: Missing address\n");
            printf(peripherals_usage);
            return -1;
        }
        const int chan = atoi(argv[2]);

        if (argc < 5)
        {
            printf("Error: Missing data\n");
            printf(peripherals_usage);
            return -1;
        }
        const int duty = atoi(argv[3]);
        if (duty < 0 || duty > 255)
        {
            printf("Error: Invalid duty\n");
            return -1;
        }
        const int freq = atoi(argv[4]);
        if (freq < 0 || freq > 255)
        {
            printf("Error: Invalid freq\n");
            return -1;
        }

        peripherals_set_pwm(chan, duty, freq);
        return 0;
    }
    if (!strcmp(argv[1], "uartwr"))
    {
        if (argc < 3)
        {
            printf("Error: Missing UART data\n");
            return -1;
        }
        peripherals_write_uart(argv[2]);
        return 0;
    }
    if (!strcmp(argv[1], "uartrd"))
    {
        printf("%s\n", peripherals_read_uart().c_str());
        return 0;
    }
    printf("Error: Unknown command\n");
    return -1;
}

struct set_mac_args
{
    struct arg_str* mac;
    struct arg_end* end;
};

set_mac_args set_peer_mac_args;

int set_peer_mac(int argc, char** argv)
{
    int nerrors = arg_parse(argc, argv, (void**) &set_peer_mac_args);
    if (nerrors != 0)
    {
        arg_print_errors(stderr, set_peer_mac_args.end, argv[0]);
        return 1;
    }
    const auto peer_mac = set_peer_mac_args.mac->sval[0];
    if (!set_peer_mac(peer_mac))
    {
        printf("ERROR: Invalid MAC\n");
        return 1;
    }
    printf("OK: Peer MAC set to %s\n", peer_mac);
    return 0;
}

set_mac_args set_my_mac_args;

int set_my_mac(int argc, char** argv)
{
    int nerrors = arg_parse(argc, argv, (void**) &set_my_mac_args);
    if (nerrors != 0)
    {
        arg_print_errors(stderr, set_my_mac_args.end, argv[0]);
        return 1;
    }
    const auto my_mac = set_my_mac_args.mac->sval[0];
    if (!set_my_mac(my_mac))
    {
        printf("ERROR: Invalid MAC\n");
        return 1;
    }
    printf("OK: My MAC set to %s\n", my_mac);
    return 0;
}

static int reboot(int, char**)
{
    printf("Reboot...\n");
    esp_restart();
    return 0;
}

void initialize_console()
{
    setvbuf(stdin, NULL, _IONBF, 0);
    uart_vfs_dev_port_set_rx_line_endings(0, ESP_LINE_ENDINGS_CR);
    uart_vfs_dev_port_set_tx_line_endings(0, ESP_LINE_ENDINGS_CRLF);

    uart_config_t uart_config;
    memset(&uart_config, 0, sizeof(uart_config));
    uart_config.baud_rate = CONFIG_ESP_CONSOLE_UART_BAUDRATE;
    uart_config.data_bits = UART_DATA_8_BITS;
    uart_config.parity = UART_PARITY_DISABLE;
    uart_config.stop_bits = UART_STOP_BITS_1;
    uart_config.source_clk = UART_SCLK_REF_TICK;
    ESP_ERROR_CHECK(uart_param_config((uart_port_t) CONFIG_ESP_CONSOLE_UART_NUM, &uart_config));

    ESP_ERROR_CHECK(uart_driver_install((uart_port_t) CONFIG_ESP_CONSOLE_UART_NUM,
                                         256, 0, 0, NULL, 0));
    uart_vfs_dev_use_driver(CONFIG_ESP_CONSOLE_UART_NUM);

    esp_console_config_t console_config;
    memset(&console_config, 0, sizeof(console_config));
    console_config.max_cmdline_args = 8;
    console_config.max_cmdline_length = 256;
#if CONFIG_LOG_COLORS
    console_config.hint_color = atoi(LOG_COLOR_CYAN);
#endif
    ESP_ERROR_CHECK(esp_console_init(&console_config));

    linenoiseSetMultiLine(1);
    linenoiseSetCompletionCallback(&esp_console_get_completion);
    linenoiseSetHintsCallback((linenoiseHintsCallback*) &esp_console_get_hint);
    linenoiseHistorySetMaxLen(100);
}

void run_console()
{
    initialize_console();

    esp_console_register_help_command();

    const esp_console_cmd_t cmd1 = {
        .command = "motortest",
        .help = "Test the motors",
        .hint = NULL,
        .func = &motor_test,
        .argtable = nullptr
    };
    ESP_ERROR_CHECK(esp_console_cmd_register(&cmd1));

    const esp_console_cmd_t cmd2 = {
        .command = "i2c",
        .help = "Manage I2C devices",
        .hint = NULL,
        .func = &i2c_cmd,
        .argtable = nullptr
    };
    ESP_ERROR_CHECK(esp_console_cmd_register(&cmd2));

    const esp_console_cmd_t cmd3 = {
        .command = "readbattery",
        .help = "Read battery voltage",
        .hint = NULL,
        .func = &read_battery,
        .argtable = nullptr
    };
    ESP_ERROR_CHECK(esp_console_cmd_register(&cmd3));

    const esp_console_cmd_t cmd4 = {
        .command = "peripherals",
        .help = "Control peripherals",
        .hint = NULL,
        .func = &control_peripherals,
        .argtable = nullptr
    };
    ESP_ERROR_CHECK(esp_console_cmd_register(&cmd4));

    const esp_console_cmd_t cmd5 = {
        .command = "sound",
        .help = "Play sound",
        .hint = NULL,
        .func = &sound,
        .argtable = nullptr
    };
    ESP_ERROR_CHECK(esp_console_cmd_register(&cmd5));

    set_peer_mac_args.mac = arg_str1(NULL, NULL, "<mac>", "MAC");
    set_peer_mac_args.end = arg_end(2);
    const esp_console_cmd_t set_peer_mac_cmd = {
        .command = "peermac",
        .help = "Set peer MAC",
        .hint = nullptr,
        .func = &set_peer_mac,
        .argtable = &set_peer_mac_args
    };
    ESP_ERROR_CHECK(esp_console_cmd_register(&set_peer_mac_cmd));

    set_my_mac_args.mac = arg_str1(NULL, NULL, "<mac>", "MAC");
    set_my_mac_args.end = arg_end(2);
    const esp_console_cmd_t set_my_mac_cmd = {
        .command = "mymac",
        .help = "Set my MAC",
        .hint = nullptr,
        .func = &set_my_mac,
        .argtable = &set_my_mac_args
    };
    ESP_ERROR_CHECK(esp_console_cmd_register(&set_my_mac_cmd));

    const esp_console_cmd_t reboot_cmd = {
        .command = "reboot",
        .help = "Reboot",
        .hint = nullptr,
        .func = &reboot,
        .argtable = nullptr
    };
    ESP_ERROR_CHECK(esp_console_cmd_register(&reboot_cmd));
    
    const char* prompt = LOG_COLOR_I "esp32> " LOG_RESET_COLOR;

    printf("\n"
           "Type 'help' to get the list of commands.\n"
           "Use UP/DOWN arrows to navigate through command history.\n"
           "Press TAB when typing command name to auto-complete.\n");

    int probe_status = linenoiseProbe();
    if (probe_status)
    {
        printf("\n"
               "Your terminal application does not support escape sequences.\n"
               "Line editing and history features are disabled.\n"
               "On Windows, try using Putty instead.\n");
        linenoiseSetDumbMode(1);
#if CONFIG_LOG_COLORS
        prompt = "esp32> ";
#endif //CONFIG_LOG_COLORS
    }

    while (true)
    {
        char* line = linenoise(prompt);
        if (line == NULL)
            continue;

        linenoiseHistoryAdd(line);

        int ret;
        esp_err_t err = esp_console_run(line, &ret);
        if (err == ESP_ERR_NOT_FOUND)
            printf("Unrecognized command\n");
        else if (err == ESP_ERR_INVALID_ARG)
            ; // command was empty
        else if (err == ESP_OK && ret != ESP_OK)
            printf("Command returned non-zero error code: 0x%x (%s)\n", ret, esp_err_to_name(err));
        else if (err != ESP_OK)
            printf("Internal error: %s\n", esp_err_to_name(err));

        linenoiseFree(line);
    }
}

// Local Variables:
// compile-command: "(cd ..; idf.py build)"
// End:
