bullestock/chairbot/(commit log)

2016-07-29 Initial commit.
    [base.dxf, spacer.dxf]
2016-09-06 Wait until joystick device is ready.
2016-09-06 Use dedicated LCD device; add check for Bluetooth device.
2016-09-06 Show battery voltage on LCD.
2016-09-06 Use correct PWM pins; add V command.
    [motor.ino]
2016-09-08 Read motor controller response.
2016-09-08 Add dead man's switch.
2016-09-13 Limit power.
2016-09-13 Adjust voltage sense scale factor.
2016-09-14 Open motor driver.
2016-09-16 Add options to run without LCD and/or motor driver.
2016-09-17 LCD driver class.
2016-09-17 Use LCD driver class.
2016-09-20 Make main loop more responsive. Set minimum power limit.
2016-09-20 Tune PWM.
2016-09-20 Limit power; increase responsiveness.
2016-09-29 Add rule for robot arm controller.
2016-09-29 Add rudimentary arm control.
2016-10-05 Improve autodetection of ports. Change handling of arm.
2016-10-05 Make LCD work again. Reimplement arm control.
2016-10-06 Add fourth servo.
2016-10-06 Add gripper control.
2016-10-08 Dummy sixaxis driver.
2016-10-08 Implement web framework.
2016-10-08 Implement powerup.
2016-10-08 Add support for I2C.
2016-10-09 Implement I2C correctly.
2016-10-09 Implement I2C interface.
2016-10-09 Use I2C for motor and arm control.
2016-10-09 Remove serial output from I2C.
2016-10-12 LED swag.
2016-10-12 Improve palette switching.
2016-10-12 Add I2C interface.
2017-06-11 Use only one pin for enable.
2017-06-18 Test motor control via I2C.
2017-08-09 Use a single pin for both enable inputs.
2017-08-18 Add I2C control.
2017-08-18 Rudimentary motor control
2017-08-19 Show switches.
2017-09-16 Halt motors if no data received from radio for 100 ms.
2017-09-20 Measure battery voltage.
2017-09-22 Make reading of battery voltage work.
2017-09-22 Send battery voltage as a single byte.
2017-09-22 Average battery readings.
2017-09-24 Add -motortest option.
2017-09-30 Set pinmode for MOSFET pin.
2017-09-30 Fix bug in setting CRC.
    [main.cpp]
2017-09-30 Flash lights when toggle switch is down.
2017-10-02 Add support for setting PWM frequency.
2017-10-08 Fix X-axis swap.
2017-11-16 Make left pot adjust max power.
2017-11-16 Add PWM frequency API.
2018-08-09 Use correct analog inputs.
    [motor.ino]
2018-08-17 Play around with current sense.
2018-08-17 Add peak detector circuit and PCB.
    [peakdetector.kicad_pcb, peakdetector.sch]
2018-10-15 Switch to LM324.
    [peakdetector.sch]
2018-10-15 New controller board.
    [chairbot.kicad_pcb, chairbot.sch]
2018-10-24 Work on schematic.
    [chairbot.sch, motor.sch]
2018-10-25 Add nRF24L01.
    [chairbot.sch]
2018-10-26 Work work work.
    [chairbot.kicad_pcb, chairbot.sch, motor.sch]
2018-10-27 Add remaining connections.
    [chairbot.kicad_pcb, chairbot.sch]
2018-11-01 Work on PCB.
    [chairbot.kicad_pcb, chairbot.sch]
2018-11-03 Finish routing.
    [chairbot.kicad_pcb]
2018-11-13 Add proper footprint for peak detector.
    [chairbot.kicad_pcb, motor.sch]
2018-11-17 Do more routing.
    [chairbot.kicad_pcb, chairbot.sch]
2018-11-20 Finalize layout.
    [chairbot.kicad_pcb, chairbot.sch]
2019-04-06 Blink the LED.
2019-04-06 Implement motor test.
2019-04-07 Add room for antenna connector.
2019-04-07 PCB mount.
2019-04-07 Move MISO from IO0 to IO27.
    [chairbot.sch]
2019-04-07 Fix footprint for diodes.
2019-04-14 Add support for repeating motor test.
2019-04-16 Fix various issues.
    [chairbot.kicad_pcb, chairbot.sch]
2019-04-16 Handle brake.
2019-04-16 Add I2C scan.
2019-04-17 Fix more stuff.
    [chairbot.kicad_pcb, motor.sch]
2019-05-05 Add battery measurement.
2019-05-06 Enable motors.
2019-06-30 Add I2C board.
    [peripherals.sch]
2019-07-01 Tweak pin numbers.
    [chairbot.kicad_pcb, chairbot.sch, motor.sch]
2019-07-01 Start PCB layout.
    [peripherals.kicad_pcb, peripherals.sch]
2019-07-01 Route more tracks.
    [peripherals.kicad_pcb, peripherals.sch]
2019-07-02 Complete routing.
    [peripherals.kicad_pcb, peripherals.sch]
2019-07-21 Add PWM1/2 control.
2019-07-28 Tune motor PWM frequency; make toggle more responsive.
2019-07-28 Extend i2c command; add peripherals command.
2019-08-24 Add stop play command.
    Fix sounds per bank.
    [peripherals.ino]
2019-08-25 Fix sounds per bank.
    [peripherals.ino]
2019-08-25 Fix sound bug; increase PWM2 frequency.
    [peripherals.ino]
2019-08-25 Play sound from different banks according to button.
2019-09-21 Make a task for playing sound to avoid halting main control loop.
    [main.cpp, peripherals.cpp, peripherals.h]
2019-09-21 Handle all I2C communication in separate task.
2019-10-13 Fix pivot overflow bug; invert steering.
    [motor.cpp]
2019-10-20 SMD version.
    [peripherals.kicad_pcb, peripherals.sch, pwm.sch]
2019-11-18 Fix ADC attenuation setting.
    [peripherals.cpp]
2019-11-21 Improve steering.
2019-11-22 Fix pin numbers.
2019-11-23 Power distribution.
    [powerbar-B_Cu.gbr, powerbar-B_Mask.gbr, powerbar-B_Paste.gbr, powerbar-B_SilkS.gbr, powerbar-Edge_Cuts.gbr, powerbar-F_Cu.gbr, powerbar-F_Mask.gbr, powerbar-F_Paste.gbr]
2020-10-01 Add support for all 4 PWM outputs.
2020-10-03 Remove DFPlayer.
    [peripherals.sch, pwm.sch]
2020-10-08 Clamp low power levels to zero.
2020-10-09 Work on layout.
    [peripherals.kicad_pcb, peripherals.sch, pwm.sch]
2021-08-10 Swap RX and TX.
    [peripherals.ino]
2021-08-14 Fix MOSFET polarity.
    [peripherals.kicad_pcb, peripherals.kicad_sch]
2021-09-30 Add LED test command.
2022-01-02 Fix 3D models.
    [peripherals.kicad_pcb]
2024-09-02 Start porting to new radio driver.
2024-09-02 Rewrite motor driver to use LEDC.
2024-09-03 Update ADC code for ESP-IDF 5.
    [chairbot.sch]
2024-09-07 Start porting to new I2C driver.
2024-09-07 Fix nRF pin defs.
    [config.h, peripherals.cpp, radio.cpp]
2024-09-07 Do not use LED on GPIO22.
2024-09-08 Port I2C console commands to new driver.
2024-09-12 Adapt i2c write to the simple protocol used by peripherals.ino.
2024-09-18 Add mirf component, update I2C code.
2024-09-18 Fix LEDC timer parameter.
    [motor.cpp]
2024-12-05 Fix motor PWM scaling.
    [motor.cpp]
2024-12-20 Fix I2C handling.
2025-01-04 Rewrite radio handling. Avoid addressing peripherals if they are not present.
    [main.cpp, peripherals.cpp, peripherals.h, peripherals.ino, radio.cpp, radio.h]
2025-02-08 Update KiCAD version.
    [peripherals.kicad_sch, peripherals.sch, pwm.kicad_sch, pwm.sch]
2025-02-20 Only send changes over I2C bus.
2025-02-27 Fix assumption that maximum analog value is 255.
    [main.cpp, motor.cpp]
2025-04-17 Rewrite clamping.
2025-04-21 Arm beta axis.
2025-05-24 Mount for endstop.
2025-05-24 Bump for hitting endstop.
2025-12-12 Simple bracket.
2025-12-13 Bearing mounts.
2025-12-13 Support for bearings.
2025-12-13 Add decorative holes.
2026-01-02 Add sounds partition.
    [partitions.csv]
2026-01-02 Enlarge sound partition.
    [partitions.csv]
2026-01-11 Add cutout, mounting holes for stepper.
2026-01-11 Add missing files.
    [chairbot.kicad_pcb, chairbot.kicad_sch]
2026-01-13 Part inside bearing.
2026-01-14 Outer bearing adapter.
2026-01-16 Fix hole positions, remove base mount holes.
2026-01-16 Increase height by 3 mm.
2026-03-29 Update for geared stepper.
2026-04-01 Save new empty module before KiCAD fucks it up.
2026-04-01 Complete overall schematic.
    [chairbot.kicad_pcb, chairbot.kicad_sch, motor.kicad_sch]
2026-04-01 Fix errors.
    [chairbot.kicad_pcb, chairbot.kicad_sch, chairbot.sch, motor.kicad_sch, motor.sch]
2026-04-01 Add zones.
    [chairbot.kicad_pcb]
2026-04-03 Final touches.
    [chairbot.kicad_pcb]
2026-04-05 Add support for UART passthrough.
2026-04-08 Add UART support.
2026-04-08 Add UART read support.
2026-04-08 Route UART to J10.
    [peripherals.kicad_pcb, peripherals.kicad_sch, pwm.kicad_sch]
2026-04-22 Fix UART read.
2026-05-23 Add console sound support.
    [partitions.csv]
2026-05-23 Update for new PCB.
2026-05-23 Fix playback of short files.
    [i2s_audio.cpp]
2026-05-24 Fix audio bugs, convert WAV files to stereo.
    [i2s_audio.cpp]
2026-05-24 Improve 'sound check' command; fix sound files.
    [console.cpp]
2026-05-25 Stick for pressing boot button on remote.
2026-05-25 Fix code after protocol update.
    [main.cpp, motor.cpp, motor.h]
2026-05-25 Add PWM argument validation.
2026-05-25 Sort track list.
2026-06-01 Fix leading slash in track names.
    [i2s_audio.cpp]
2026-08-02 Cover for main power switch, body.
2026-08-22 Fix holes.
2026-08-22 Remove holes.
2026-08-29 Add options to motor_test command.
2026-08-29 Add brake test.
2026-09-11 Adjust holes.
2026-10-27 Mount plate for controller+peripherals.
2026-11-09 Add grblHAL settings for BTT SKR Pico.
2026-11-09 Save grblHAL compile options.
